yawangjiang/arduino-car/data/README.md

# 实验数据

这里只收录可从报告追溯的数字，不把平滑示意曲线反推成测量数据。

| 文件 | 内容 | 来源 |
| --- | --- | --- |
| [LDR 原始读数](ldr/measurements.csv) | 2 只 × 3 档电阻 × 2 种连接标记 × 4 档光照 × 5 次重复，共 240 条 ADC | Lab 1 附录绘图字典 |
| [红外高度响应](infrared/height_response.csv) | 5-50 mm，每档 3 次 ADC 与报告均值，共 10 档 | Lab 3 第 6 页 Table 1 |
| [电机计时](motor/speed_trials.csv) | 两种接线、各四档速度、每档 3 次计时 | Lab 2 第 6 页 Table 1 |

LDR 的 `VCC/GND` 与光照标签沿用报告，光照是定性档位，不是标定后的 Lux。报告阻值换算与接线描述存在冲突，因此只保存原始 ADC，不沿用可能有误的电阻计算。

电机报告写距离 6 m，部分表格速度乘时间约为 4.5 m。`confirmed_distance_m` 留空，`reported_speed_m_s` 只代表报告数字，实际距离确认前不据此重算性能提升。

红外表格的 ADC 随高度增加而上升，讨论却写下降；文件保留表格数字。报告中 80 mm 安装高度也与测试范围不一致。

资料没有环境时间序列、超声波逐次误差或六轴连续记录，本仓库未新增这类数据。可使用独立草图重新采集，并排除串口错误消息行。

[返回项目首页](../README.md)
