yawangjiang/arduino-car/docs/module-source-notes.md

# 全功能来源与修改记录

材料来自 Yuanxi HAN 提供的五份课程报告。本仓库保存整理后的代码、图片与可追溯数据，未上传整份报告。引用页码为印在正文底部的页码。

## 程序来源

| 草图或数据 | 原材料 | 整理方式 |
| --- | --- | --- |
| 寻光 | 期末报告 3.1，第 20-23 页 | 原引脚、参数与逻辑保留，详见[寻光来源](source-notes.md) |
| PD 循迹 | 期末报告 3.2，第 23-27 页 | 保留状态表、PD 和时序；增加 ADC 初始化失败停车，二进制写法改为 `0b...` |
| 超声波避障 | 期末报告 3.3，第 27-33 页 | 补全被裁切的状态入口，修正扫描方向、停车覆盖和无效回波处理 |
| 环境与惯性联动 | 期末报告 3.4，第 33-35 页 | 保留 Z 轴阈值、PWM 与量程；增加初始化/读取失败停车，补单位并移除未使用 ADS1115 |
| BME280 独立观察仪 | 期末报告 3.4 的 BME280 读取部分 | 拆出独立程序，增加 CSV、读数检查，不控制电机 |
| MPU6050 独立观察仪 | 期末报告 3.4 的六轴读取部分 | 拆出独立程序，增加 CSV 与模长观测，不控制电机 |
| 四线/六线电机实验 | Lab 2 附录第 9-11 页 | 保留参数与软件/硬件 PWM 逻辑，补函数声明 |
| 红外采样 | Lab 3 附录第 10-11 页 | 去行号、修复排版符号与转义序列 |
| 基础循迹 | Lab 4 附录第 7-9 页 | 补全被裁切的 `setMotor()` 声明，右轮方向使用传入参数；原映射保留 |
| LDR 采样与原始数据 | Lab 1 文档附录 | 去行号；数据字典只做字面量解析，不执行报告内代码 |
| 超声波独立测距 | 期末报告 3.3 测距函数 | 拆出诊断草图，增加 CSV 和无效标记 |
| I2C 扫描 | 本次补充 | 用于排查共享总线地址，不称为课程原附录代码 |

## 避障恢复与修正

PDF 第 32 页（正文第 31 页）的 `enterState()` 多行超出页面，缺失内容无法逐字恢复。整理版根据状态名称、左右观察参数和已存在的动作函数重建，不能视为原 `.ino` 的逐字副本。

`byte sweepDir` 无法表达 -1，改为 `int8_t`；原前行分支进入停车状态后仍执行 `advance()`，改为立即退出该分支；原先把超时记成 400 cm，改为无效 0 并停车重试。启动及恢复后也等待有效回波，恢复结束时不再覆盖停车输出。

原后退参数、40/12 cm 阈值、175 ms 转向与随机转向选择保留。删除未使用的 `currentAngle`、`maxSpeed`、舵机范围常量不影响实际动作。以上修改均有控制回归测试，仍需实车确认。

## 正文与实现的差异

- 循迹默认 `Ki=0`，实际是 PD；误差取状态表，丢线找线固定方向，没有独立 10 ms 调度。
- 避障附录没有正文的几何投影与固定右转 90°，运动角度不能从时间直接认定。
- 惯性联动使用原始 Z 轴，不是加速度模长；没有 250 ms 时间消抖，`+1.6` 只影响显示。
- 正文提到 LCD，附录没有对应库、地址或代码，当前实际显示入口是串口。
- 图像和实物按其实际内容命名：MPU6050 Figure 11 是器件示意；BME/BMP280 丝印照片不能单凭外观证明湿度功能。
- 无对应原始数据的 Figure 7、9、12 不作为性能或精度测量依据。Figure 12 有负值，是 Z 轴而非模长。

## 图片与数据

新增十张图来自期末报告 Figure 5-14，连同原寻光六张，共 16 张。每张图的文件路径、原图编号、PDF 页序、正文页码与哈希记录于[素材清单](../media/manifest.json)，提取后未重绘或裁切。

三份数据文件的测量范围、口径冲突和缺失项见[数据说明](../data/README.md)。没有添加环境、超声波或六轴的虚构连续记录。

## 官方参考

- [Adafruit ADS1X15](https://github.com/adafruit/Adafruit_ADS1X15)
- [Adafruit BME280](https://github.com/adafruit/Adafruit_BME280_Library)
- [Adafruit MPU6050](https://github.com/adafruit/Adafruit_MPU6050)
- [Arduino Servo](https://github.com/arduino-libraries/Servo)
- [Arduino pulseIn](https://docs.arduino.cc/language-reference/en/functions/advanced-io/pulseIn/)

[返回项目首页](../README.md)
