yawangjiang/arduino-car/data/ldr/measurements.csv

sensor | fixed_resistor_ohm | connection_label | illumination_label | trial | adc
LDR1 | 10000 | VCC | Brightest | 1 | 1000
LDR1 | 10000 | VCC | Brightest | 2 | 997
LDR1 | 10000 | VCC | Brightest | 3 | 997
LDR1 | 10000 | VCC | Brightest | 4 | 994
LDR1 | 10000 | VCC | Brightest | 5 | 1002
LDR1 | 10000 | VCC | Bright | 1 | 898
LDR1 | 10000 | VCC | Bright | 2 | 900
LDR1 | 10000 | VCC | Bright | 3 | 898
LDR1 | 10000 | VCC | Bright | 4 | 897
LDR1 | 10000 | VCC | Bright | 5 | 899
LDR1 | 10000 | VCC | Dim | 1 | 776
LDR1 | 10000 | VCC | Dim | 2 | 774
LDR1 | 10000 | VCC | Dim | 3 | 769
LDR1 | 10000 | VCC | Dim | 4 | 776
LDR1 | 10000 | VCC | Dim | 5 | 779
LDR1 | 10000 | VCC | Dark | 1 | 647
LDR1 | 10000 | VCC | Dark | 2 | 646
LDR1 | 10000 | VCC | Dark | 3 | 649
LDR1 | 10000 | VCC | Dark | 4 | 655
LDR1 | 10000 | VCC | Dark | 5 | 654
LDR1 | 10000 | GND | Brightest | 1 | 14
LDR1 | 10000 | GND | Brightest | 2 | 14
LDR1 | 10000 | GND | Brightest | 3 | 14
LDR1 | 10000 | GND | Brightest | 4 | 16
LDR1 | 10000 | GND | Brightest | 5 | 16
LDR1 | 10000 | GND | Bright | 1 | 107
LDR1 | 10000 | GND | Bright | 2 | 111
LDR1 | 10000 | GND | Bright | 3 | 105
LDR1 | 10000 | GND | Bright | 4 | 106
LDR1 | 10000 | GND | Bright | 5 | 110
LDR1 | 10000 | GND | Dim | 1 | 242
LDR1 | 10000 | GND | Dim | 2 | 241
LDR1 | 10000 | GND | Dim | 3 | 242
LDR1 | 10000 | GND | Dim | 4 | 242
LDR1 | 10000 | GND | Dim | 5 | 243
LDR1 | 10000 | GND | Dark | 1 | 371
LDR1 | 10000 | GND | Dark | 2 | 383
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
LDR2 | 270 | GND | Dim | 3 | 944
LDR2 | 270 | GND | Dim | 4 | 946
LDR2 | 270 | GND | Dim | 5 | 946
LDR2 | 270 | GND | Dark | 1 | 968
LDR2 | 270 | GND | Dark | 2 | 970
LDR2 | 270 | GND | Dark | 3 | 970
LDR2 | 270 | GND | Dark | 4 | 970
LDR2 | 270 | GND | Dark | 5 | 971
