yawangjiang/arduino-car/(commit log)

2026-10-27 Add Arduino light-seeking car project
2026-10-27 Organize Arduino car modules, experiments and documentation
    [height_response.csv, measurements.csv, speed_trials.csv]
